ian-ross/morse-blinkies/example-blinky/v1-broken/photos/01-k-blinky-top.jpg

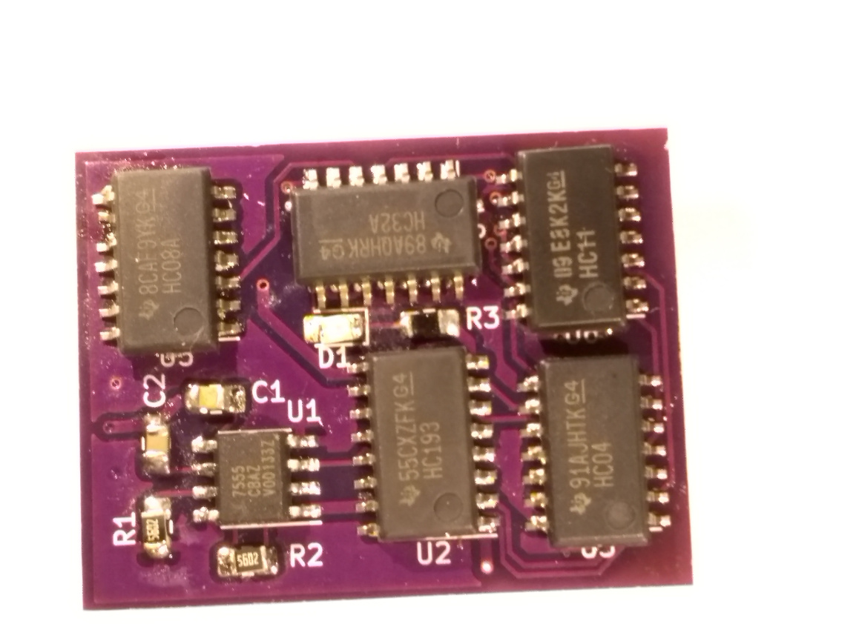
example-blinky/v1-broken/photos/01-k-blinky-top.jpg
