ian-ross/morse-blinkies/example-blinky/v1-broken/photos/02-k-blinky-detail.jpg

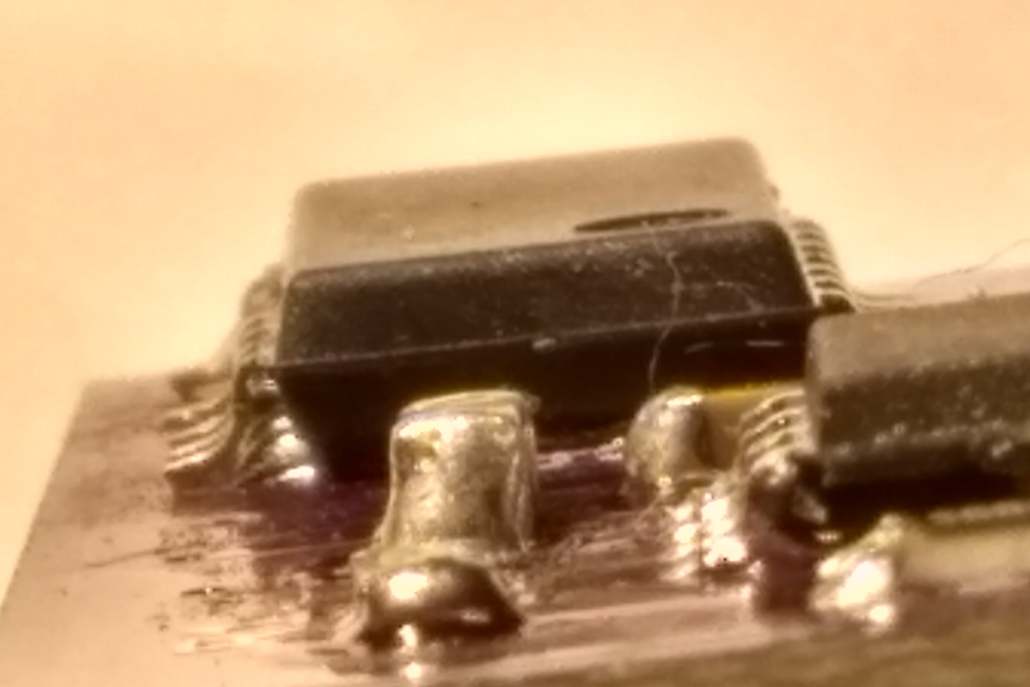
example-blinky/v1-broken/photos/02-k-blinky-detail.jpg
