ian-ross/morse-blinkies/README.md

# Morse code blinkies with KiCad, Espresso and SKIDL!

Silly project, explained
[here](https://www.skybluetrades.net/projects/morse-blinkies-as-a-service/).
