ian-ross/morse-blinkies/example-blinky/v1-broken/k.png

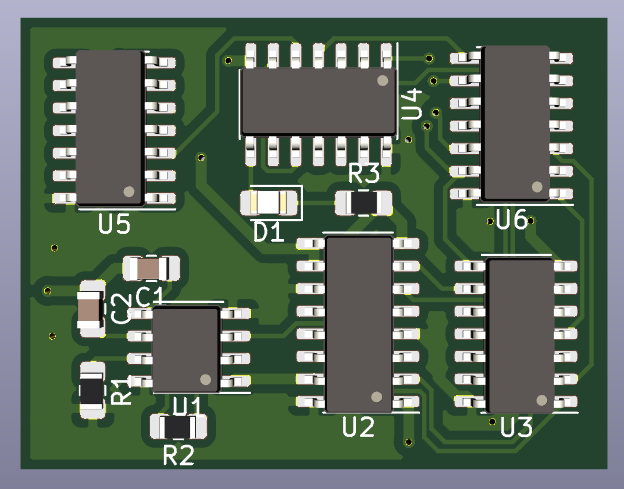
example-blinky/v1-broken/k.png
