ian-ross/morse-blinkies/experiments/simulations/ltspice/clock-1.asc

C1: cap; 0.5µ
C2: cap; 100n
D1: LED; PT-121-B
R2: res; 470K
R3: res; 1K
U1: NE555
V1: voltage; 9
Named nets: 0
.tran 0 10 0 10m
