ian-ross/morse-blinkies/(list of files, drawings)

Other design files:
experiments/simulations/logisim/a-simulation.circ
experiments/simulations/logisim/ian-simulation.circ
