ian-ross/morse-blinkies/example-blinky/v1-broken/k.kicad_pcb

## KiCad design example-blinky/v1-broken/k.kicad_pcb (2020-03-15)

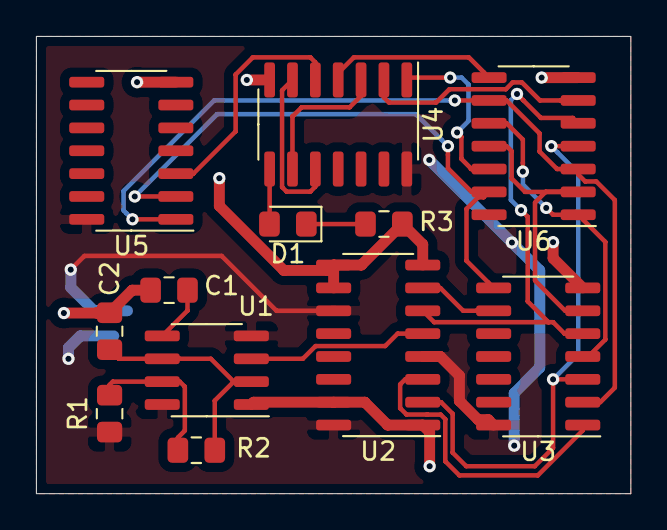
[picture p4: board k.kicad_pcb from above]

Board: 2 copper layers, 33.0 x 25.4 mm, 13 parts (1 on the bottom side), 22 nets.

Parts:
BT1: 9V; BatteryHolder_LINK_BAT-HLD-001-SMT
C1: 100n; C_0805_2012Metric_Pad1.15x1.40mm_HandSolder
C2: 1U; C_0805_2012Metric_Pad1.15x1.40mm_HandSolder
D1: LED; LED_0805_2012Metric_Pad1.15x1.40mm_HandSolder
R1, R2: 56K; R_0805_2012Metric_Pad1.15x1.40mm_HandSolder
R3: 56; R_0805_2012Metric_Pad1.15x1.40mm_HandSolder
U1: 7555; SOIC-8_3.9x4.9mm_P1.27mm
U2: 74HC193; SOIC-16_3.9x9.9mm_P1.27mm
U3: 74HC04; SOIC-14_3.9x8.7mm_P1.27mm
U4: 74HC32; SOIC-14_3.9x8.7mm_P1.27mm
U5: 74HC08; SOIC-14_3.9x8.7mm_P1.27mm
U6: 74HC11; SOIC-14_3.9x8.7mm_P1.27mm

Connections:
GND: BT1.2, C1.2, C2.1, R3.2, U1.1, U2.1, U2.8, U2.9, U2.10, U2.15, U3.7, U4.7, U5.7, U6.7
unnamed: C1.1, U1.5
unnamed: C2.2, R2.1, U1.2, U1.6
unnamed: R1.1, R2.2, U1.7
unnamed: U1.3, U2.5
unnamed: U2.3, U3.1
unnamed: U3.2, U5.1, U6.3, U6.9
unnamed: U2.2, U3.3, U6.4
unnamed: U3.4, U6.1, U6.10
unnamed: U2.6, U3.5, U6.5
unnamed: U3.6, U6.2, U6.11
unnamed: U2.7, U3.9
unnamed: U3.8, U5.2, U6.13
unnamed: U4.5, U5.3
unnamed: U4.1, U6.12
unnamed: U4.2, U6.6
unnamed: U4.3, U4.9
unnamed: U4.4, U6.8
unnamed: U4.6, U4.10
unnamed: D1.2, U4.8
unnamed: D1.1, R3.1
VDD: BT1.1, R1.2, U1.4, U1.8, U2.4, U2.11, U2.16, U3.14, U4.14, U5.14, U6.14
