ian-ross/morse-blinkies/experiments/ian-manual/ian-manual.kicad_pcb

## KiCad design experiments/ian-manual/ian-manual.kicad_pcb (2020-02-15)

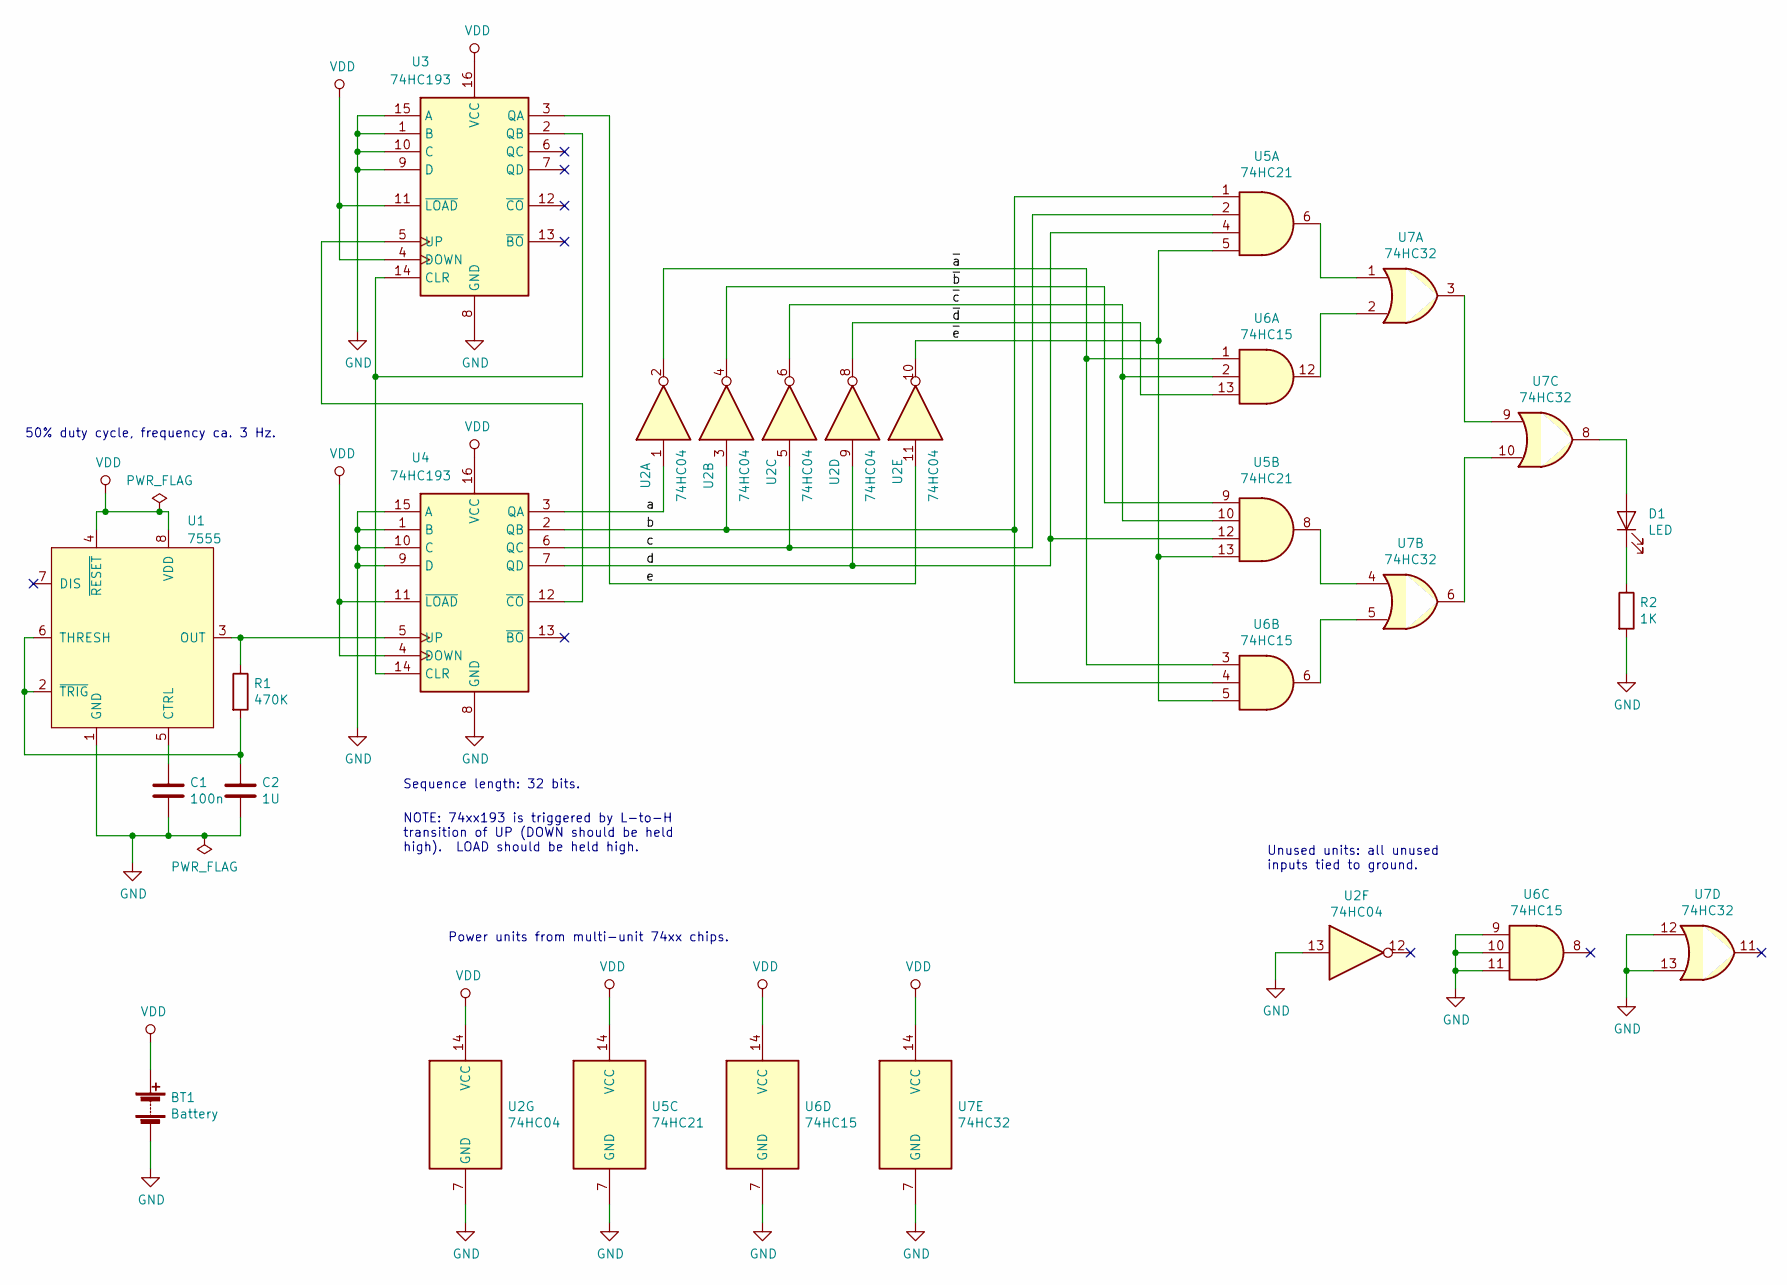
[picture p5: schematic ian-manual.sch, Manual Morse Blinky: \"IAN\"]

Parts:
BT1: Battery; BatteryHolder_LINK_BAT-HLD-001-SMT
C1: 100n; C_0805_2012Metric_Pad1.15x1.40mm_HandSolder
C2: 1U; C_0805_2012Metric_Pad1.15x1.40mm_HandSolder
D1: LED; LED_0805_2012Metric_Pad1.15x1.40mm_HandSolder
R1: 470K; R_0805_2012Metric_Pad1.15x1.40mm_HandSolder
R2: 1K; R_0805_2012Metric_Pad1.15x1.40mm_HandSolder
U1: 7555; SOIC-8_3.9x4.9mm_P1.27mm
U2: 74HC04; SOIC-14_3.9x8.7mm_P1.27mm
U3, U4: 74HC193; SOIC-16_3.9x9.9mm_P1.27mm
U5: 74HC21; SOIC-14_3.9x8.7mm_P1.27mm
U6: 74HC15; SOIC-14_3.9x8.7mm_P1.27mm
U7: 74HC32; SOIC-14_3.9x8.7mm_P1.27mm

Connections:
/a: U2.1, U4.3 (QA)
/b: U2.3, U4.2 (QB), U5.1, U6.4
/c: U2.5, U4.6 (QC), U5.2
/d: U2.9, U4.7 (QD), U5.4, U5.12
/e: U2.11, U3.3 (QA)
/~a: U2.2, U6.1, U6.3
/~b: U2.4, U5.9
/~c: U2.6, U5.10, U6.2
/~d: U2.8, U6.13
/~e: U2.10, U5.5, U5.13, U6.5
GND: BT1.2 (-), C1.2, C2.2, R2.2, U1.1 (GND), U2.7 (GND), U2.13, U3.1 (B), U3.8 (GND), U3.9 (D), U3.10 (C), U3.15 (A), U4.1 (B), U4.8 (GND), U4.9 (D), U4.10 (C), U4.15 (A), U5.7 (GND), U6.7 (GND), U6.9, U6.10, U6.11, U7.7 (GND), U7.12, U7.13
unnamed: C1.1, U1.5 (CTRL)
unnamed: C2.1, R1.2, U1.2 (~TRIG), U1.6 (THRESH)
unnamed: D1.1 (K), R2.1
unnamed: D1.2 (A), U7.8
unnamed: R1.1, U1.3 (OUT), U4.5 (UP)
unnamed: U3.5 (UP), U4.12 (~CO)
unnamed: U3.2 (QB), U3.14 (CLR), U4.14 (CLR)
unnamed: U5.6, U7.1
unnamed: U5.8, U7.4
unnamed: U6.6, U7.5
unnamed: U6.12, U7.2
unnamed: U7.3, U7.9
unnamed: U7.6, U7.10
VDD: BT1.1 (+), U1.4 (~RESET), U1.8 (VDD), U2.14 (VCC), U3.4 (DOWN), U3.11 (~LOAD), U3.16 (VCC), U4.4 (DOWN), U4.11 (~LOAD), U4.16 (VCC), U5.14 (VCC), U6.14 (VCC), U7.14 (VCC)

Notes on the sheet:
Unused units: all unused inputs tied to ground.
Power units from multi-unit 74xx chips.
50% duty cycle, frequency ca. 3 Hz.
Sequence length: 32 bits.
NOTE: 74xx193 is triggered by L-to-H transition of UP (DOWN should be held high). LOAD should be held high.

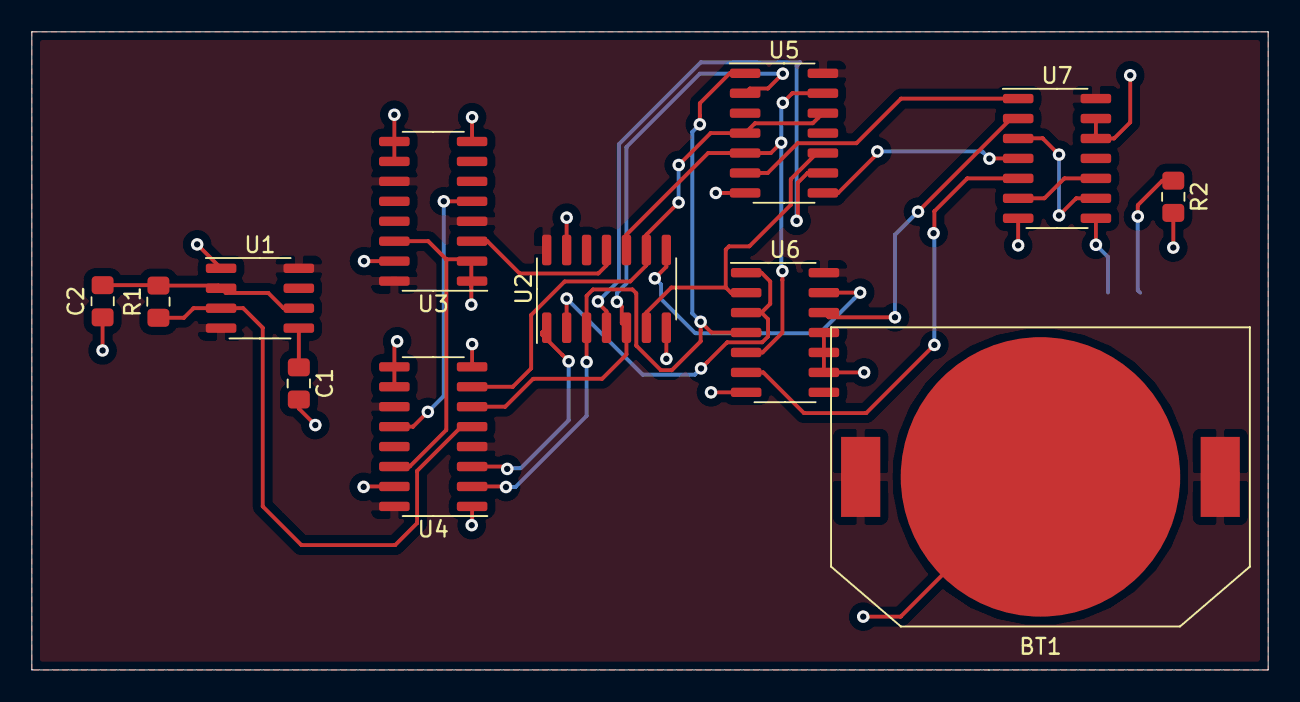
[picture p6: board ian-manual.kicad_pcb from above]

Board: 2 copper layers, 78.7 x 40.6 mm, 13 parts (1 on the bottom side), 25 nets.
