ian-ross/morse-blinkies/(commit log)

2020-02-04 Initial experiments
    [ian-manual.kicad_pcb, ian-manual.sch]
2020-02-05 Starting on Go code
    [a-simulation.circ, ian-simulation.circ]
2020-02-15 Tidying; templates for web app
    [PROJECT_NAME.kicad_pcb, PROJECT_NAME.sch, a-simulation.circ, ian-manual.kicad_pcb, ian-manual.sch, ian-simulation.circ, ian-skidl.kicad_pcb, ian-skidl.sch]
2020-02-18 MOSFET drivers...
2020-02-21 BJT drivers
2020-02-23 BOM generation
2020-02-24 Example blinky
    [k.kicad_pcb, k.sch]
2020-03-15 Footprint fixes and example blinky respin
    [k.kicad_pcb, k.sch]
